20khzdesign/procorat/RAT/FOTOS RAT ORIGINAL/IMG_0858.jpg

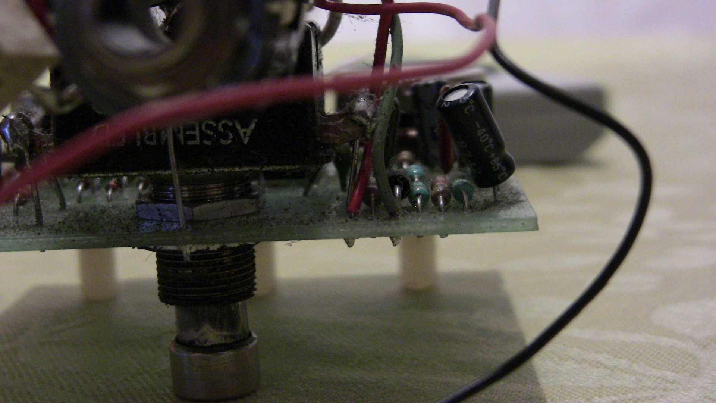
RAT/FOTOS RAT ORIGINAL/IMG_0858.jpg
