20khzdesign/procorat/RAT/FOTOS RAT ORIGINAL/IMG_0853.jpg

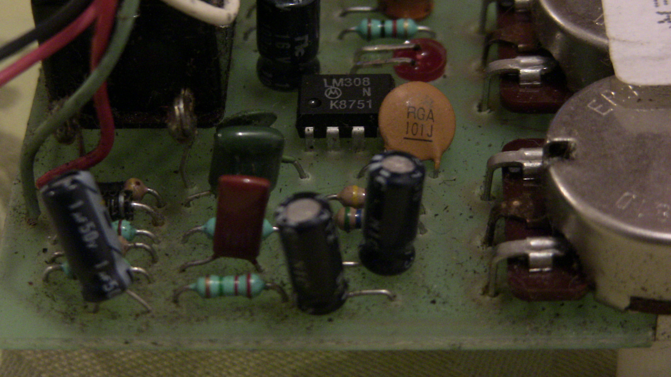
RAT/FOTOS RAT ORIGINAL/IMG_0853.jpg
