20khzdesign/procorat/RAT/LISTA COMPONENTES.txt

RESISTENCIAS

47
560
1K
1K5
2K2
10K
100K
1M
2M2
22M

CONDENSADORES

30pF
100pF
1K
3K3
10K
22K

ELECTROLITICOS

1uF
2u2
4u7
10uF
100uF

DIODOS

1N4001
1N4148

TRANSISTORES

2N5458

IC

LM308
