20khzdesign/procorat/Ficheros imprimir/PISTAS.jpg

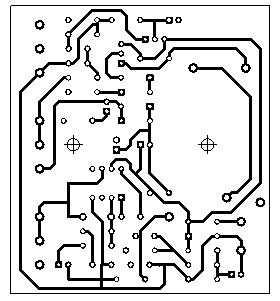
Ficheros imprimir/PISTAS.jpg
