20khzdesign/procorat/Ficheros imprimir/Referencias.jpg

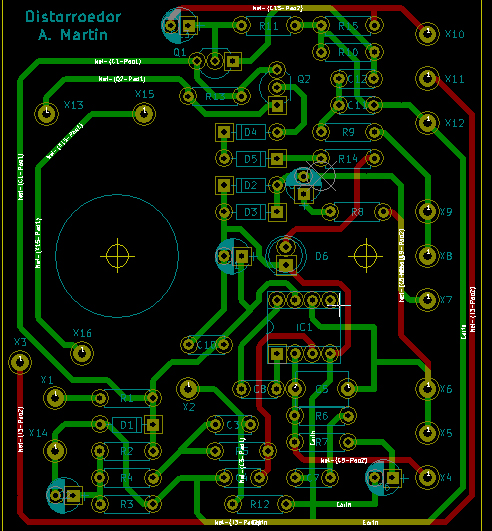
Ficheros imprimir/Referencias.jpg
