20khzdesign/procorat/Ficheros imprimir/Valores.jpg

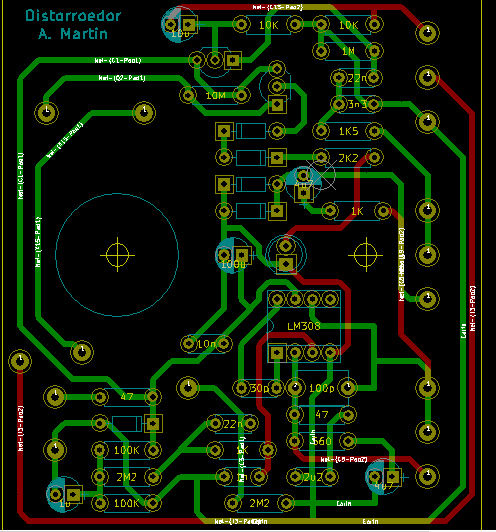
Ficheros imprimir/Valores.jpg
