20khzdesign/procorat/RAT/FOTOS RAT ORIGINAL/IMG_0848.jpg

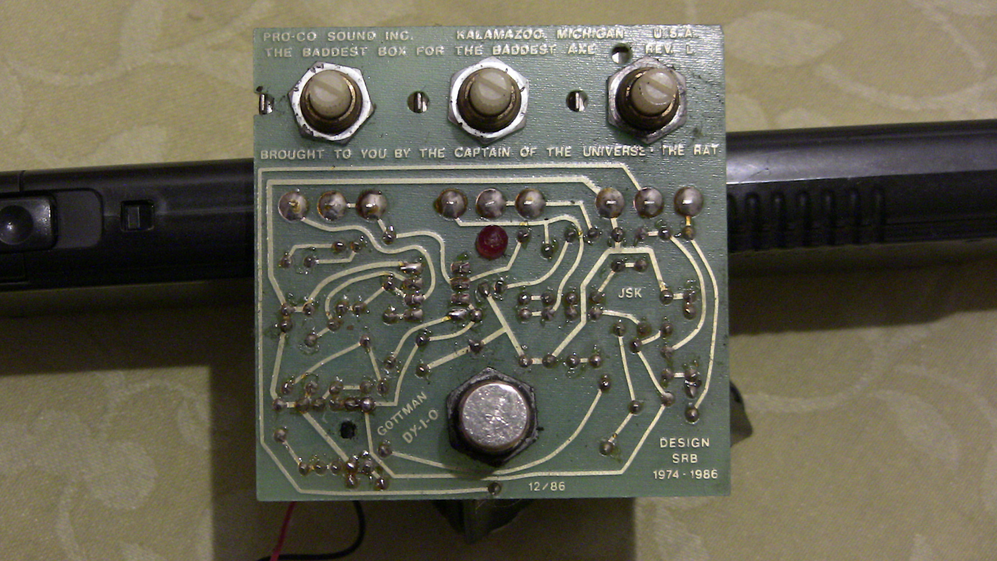
RAT/FOTOS RAT ORIGINAL/IMG_0848.jpg
