20khzdesign/procorat/RAT/FOTOS RAT ORIGINAL/IMG_0849.jpg

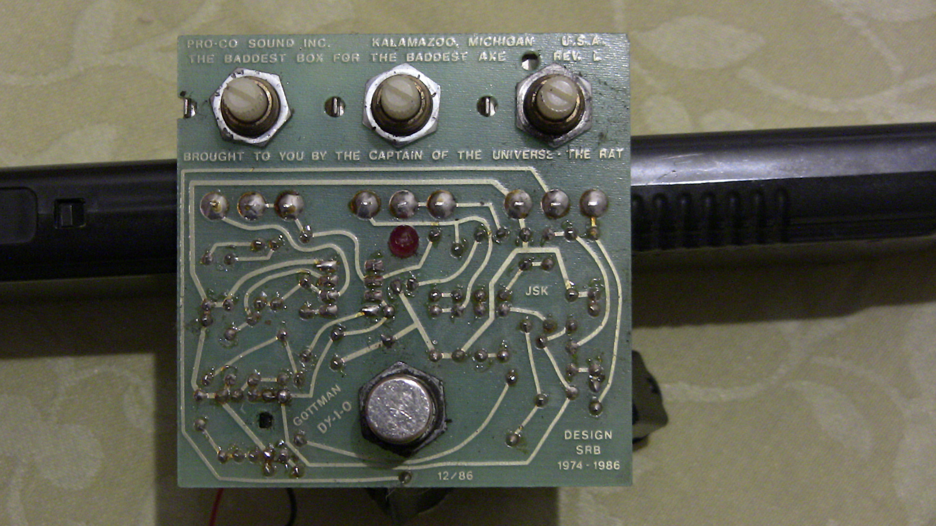
RAT/FOTOS RAT ORIGINAL/IMG_0849.jpg
