20khzdesign/procorat/RAT/FOTOS RAT ORIGINAL/IMG_0850.jpg

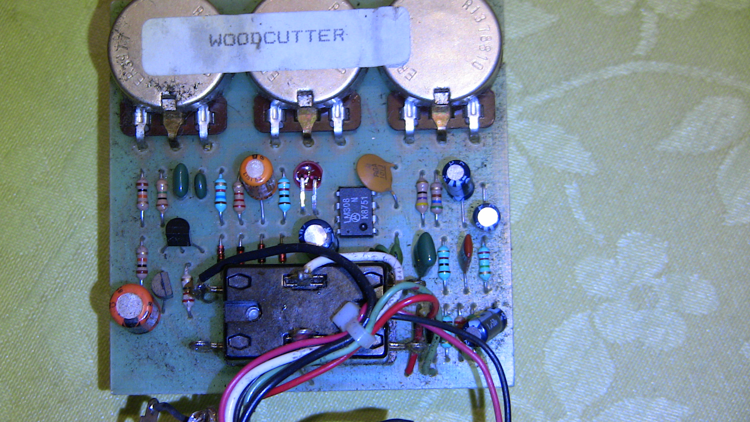
RAT/FOTOS RAT ORIGINAL/IMG_0850.jpg
