20khzdesign/procorat/RAT/FOTOS RAT ORIGINAL/IMG_0851.jpg

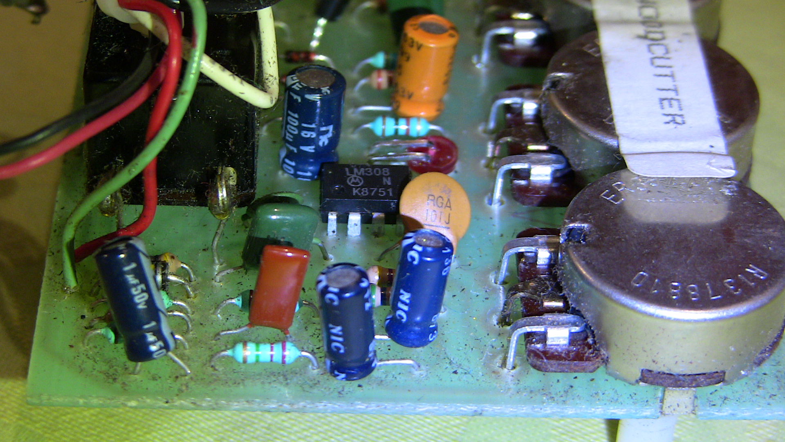
RAT/FOTOS RAT ORIGINAL/IMG_0851.jpg
