20khzdesign/procorat/RAT/FOTOS RAT ORIGINAL/IMG_0854.jpg

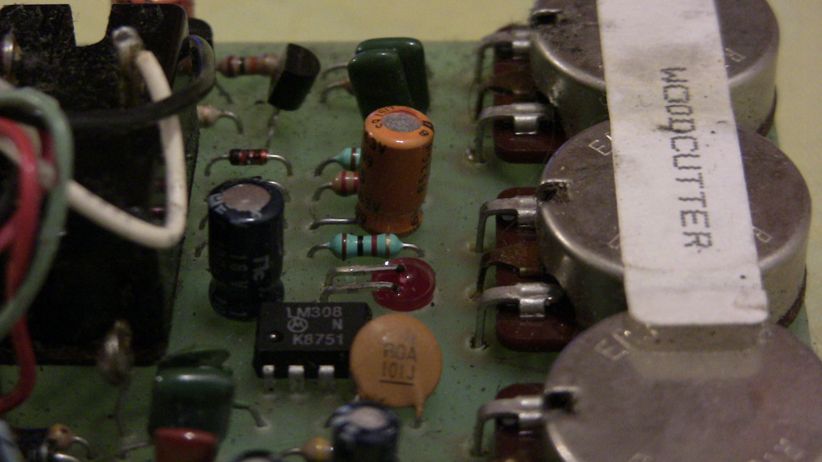
RAT/FOTOS RAT ORIGINAL/IMG_0854.jpg
