20khzdesign/procorat/RAT/FOTOS RAT ORIGINAL/IMG_0856.jpg

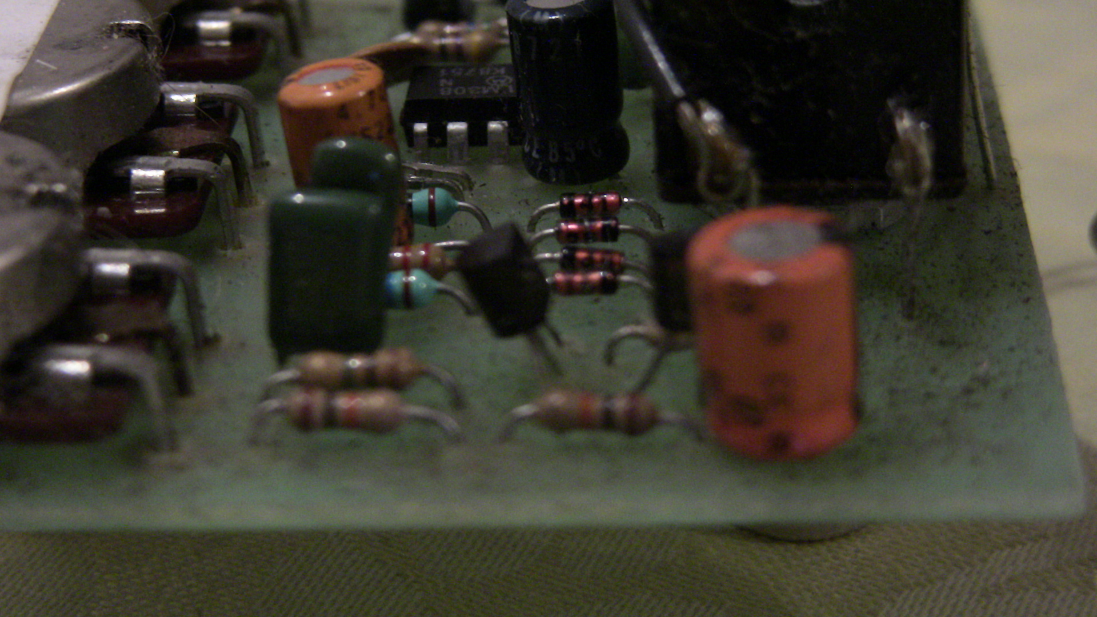
RAT/FOTOS RAT ORIGINAL/IMG_0856.jpg
