20khzdesign/procorat/RAT/FOTOS RAT ORIGINAL/IMG_0859.jpg

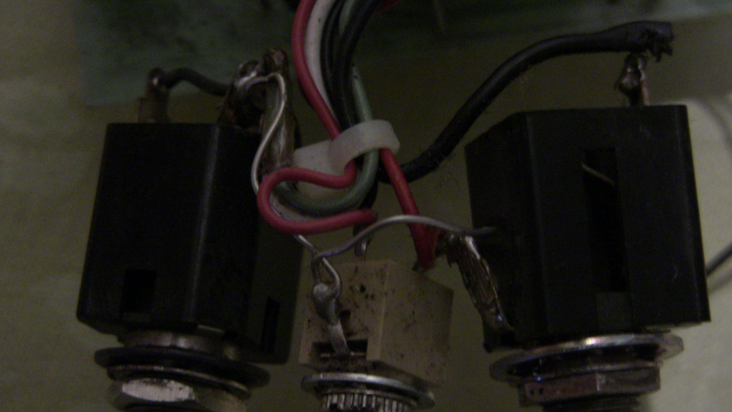
RAT/FOTOS RAT ORIGINAL/IMG_0859.jpg
