20khzdesign/procorat/RAT/RAT DE PISOTONES/ProCo RAT_archivos/image001.jpg

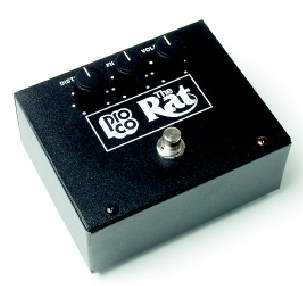
RAT/RAT DE PISOTONES/ProCo RAT_archivos/image001.jpg
