20khzdesign/procorat/RAT/RAT DE PISOTONES/ProCo RAT_archivos/image003.jpg

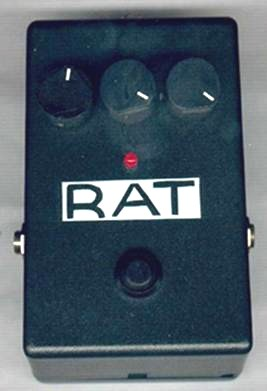
RAT/RAT DE PISOTONES/ProCo RAT_archivos/image003.jpg
