20khzdesign/procorat/RAT/RAT DE PISOTONES/ProCo RAT_archivos/image005.jpg

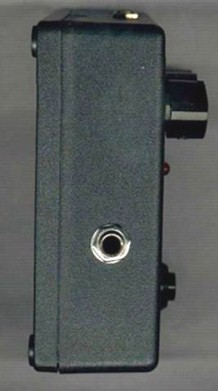
RAT/RAT DE PISOTONES/ProCo RAT_archivos/image005.jpg
