20khzdesign/procorat/RAT/RAT DE PISOTONES/ProCo RAT_archivos/RATlayout.jpg

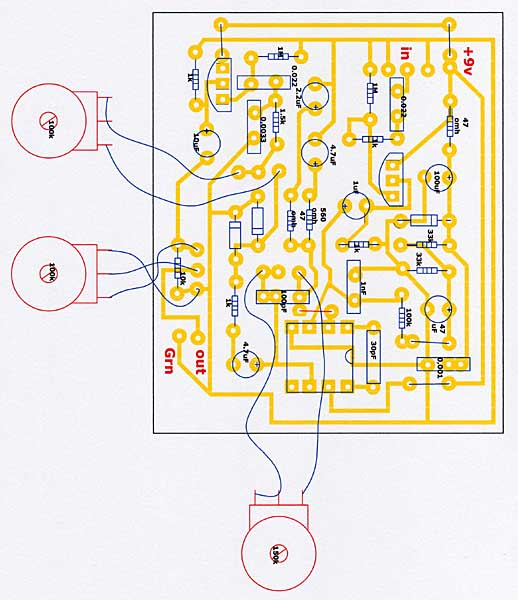
RAT/RAT DE PISOTONES/ProCo RAT_archivos/RATlayout.jpg
