20khzdesign/procorat/RAT/TUBE SOUND FUZZ PISOTONES/Tube Sound Fuzz_archivos/TSFEsquemaYComp.jpg

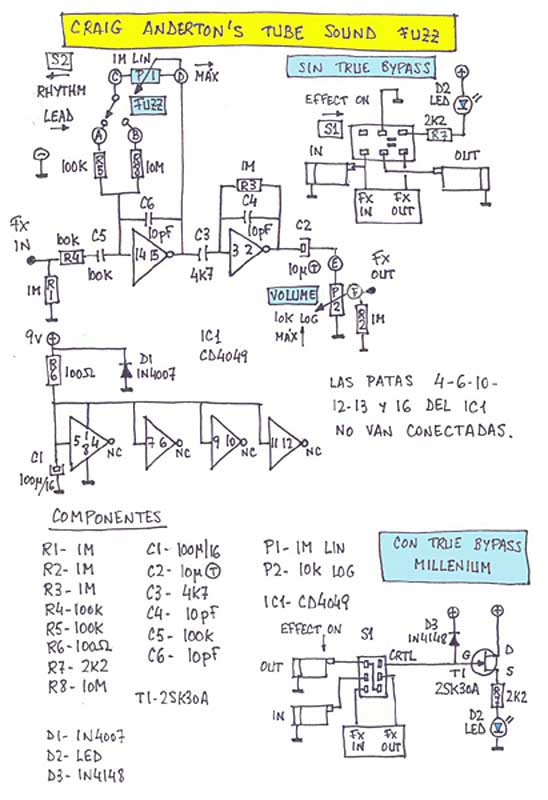
RAT/TUBE SOUND FUZZ PISOTONES/Tube Sound Fuzz_archivos/TSFEsquemaYComp.jpg
