20khzdesign/procorat/RAT/TUBE SOUND FUZZ PISOTONES/Tube Sound Fuzz_archivos/TSFExterior.jpg

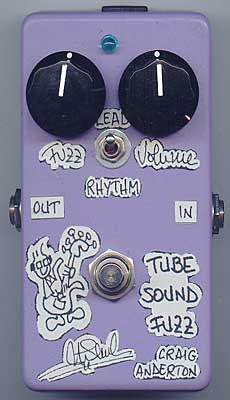
RAT/TUBE SOUND FUZZ PISOTONES/Tube Sound Fuzz_archivos/TSFExterior.jpg
