20khzdesign/procorat/RAT/TUBE SOUND FUZZ PISOTONES/Tube Sound Fuzz_archivos/TSFInterior.jpg

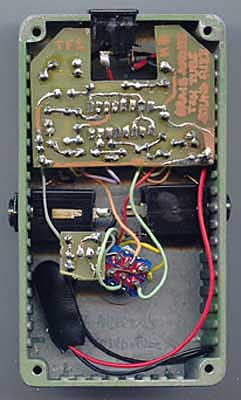
RAT/TUBE SOUND FUZZ PISOTONES/Tube Sound Fuzz_archivos/TSFInterior.jpg
