20khzdesign/procorat/RAT/TUBE SOUND FUZZ PISOTONES/Tube Sound Fuzz_archivos/TSFPlaca.jpg

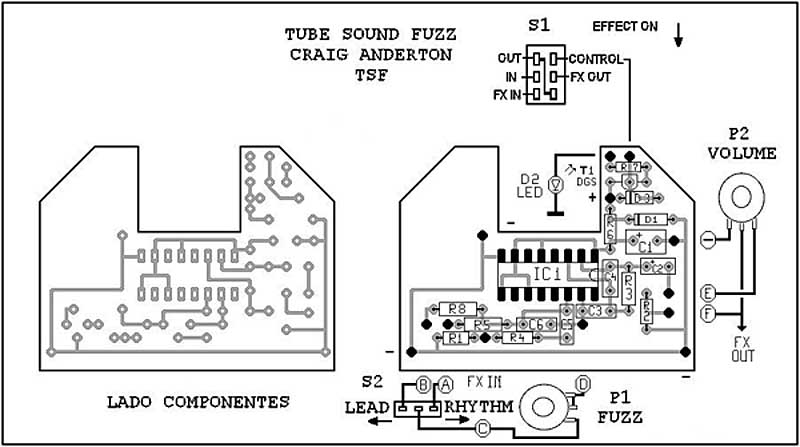
RAT/TUBE SOUND FUZZ PISOTONES/Tube Sound Fuzz_archivos/TSFPlaca.jpg
