20khzdesign/procorat/Esquema.pdf

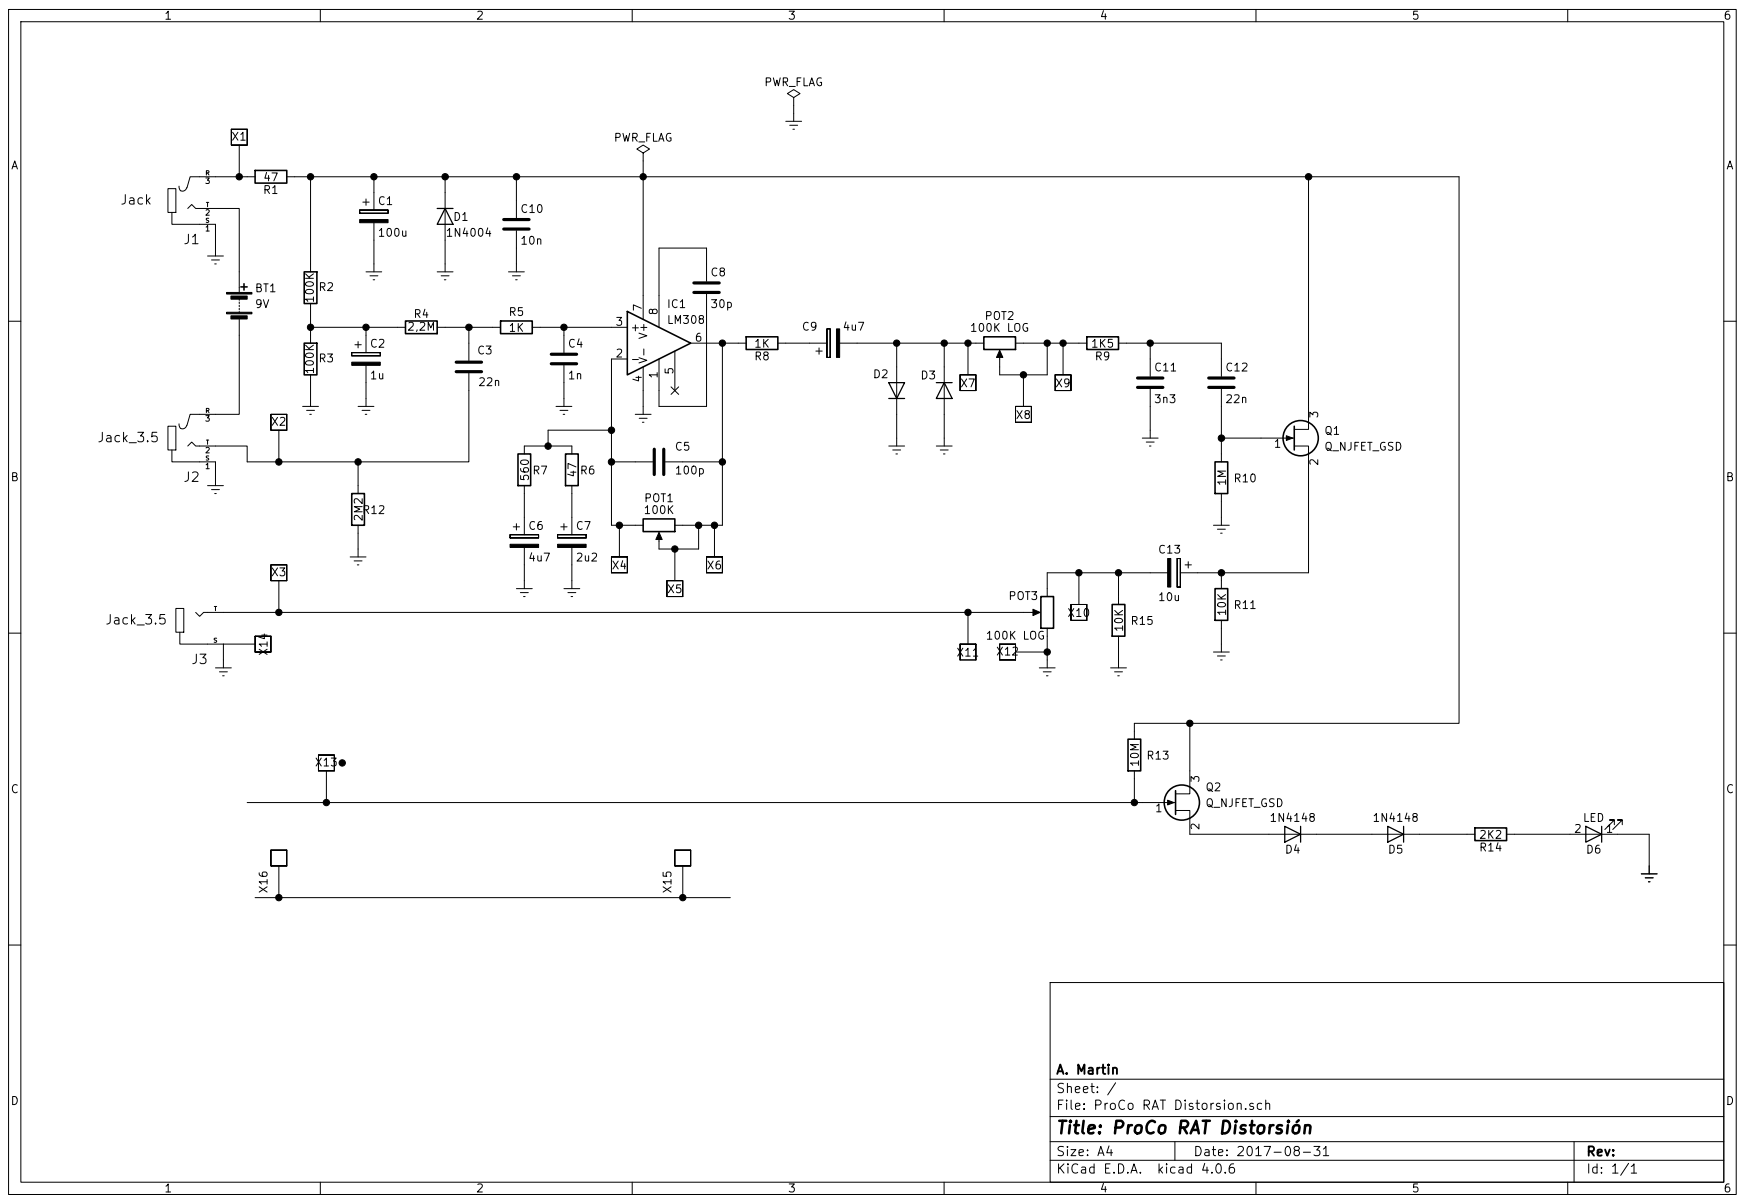
[picture p21: page 1]
