20khzdesign/procorat/Placa referencias.pdf

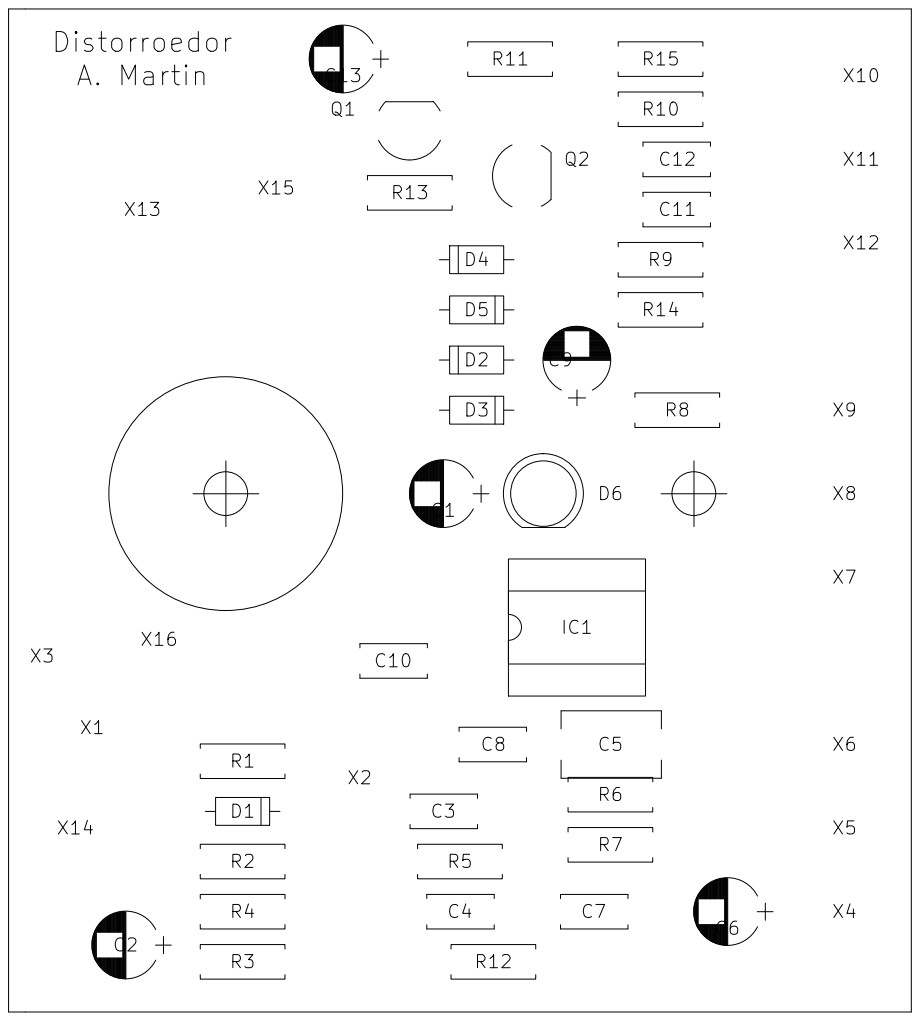
[picture p22: page 1]
