20khzdesign/procorat/Placa valores.pdf

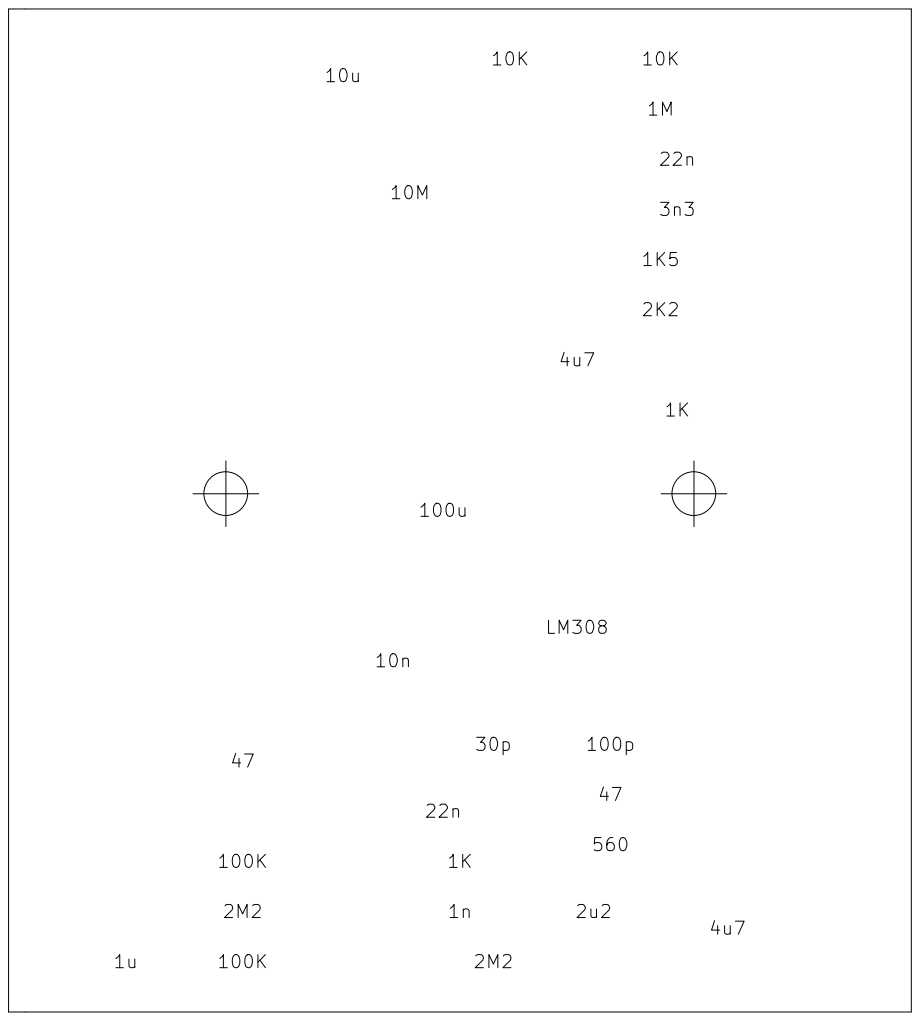
[picture p23: page 1]
