20khzdesign/procorat/Ficheros imprimir/Esquema.pdf

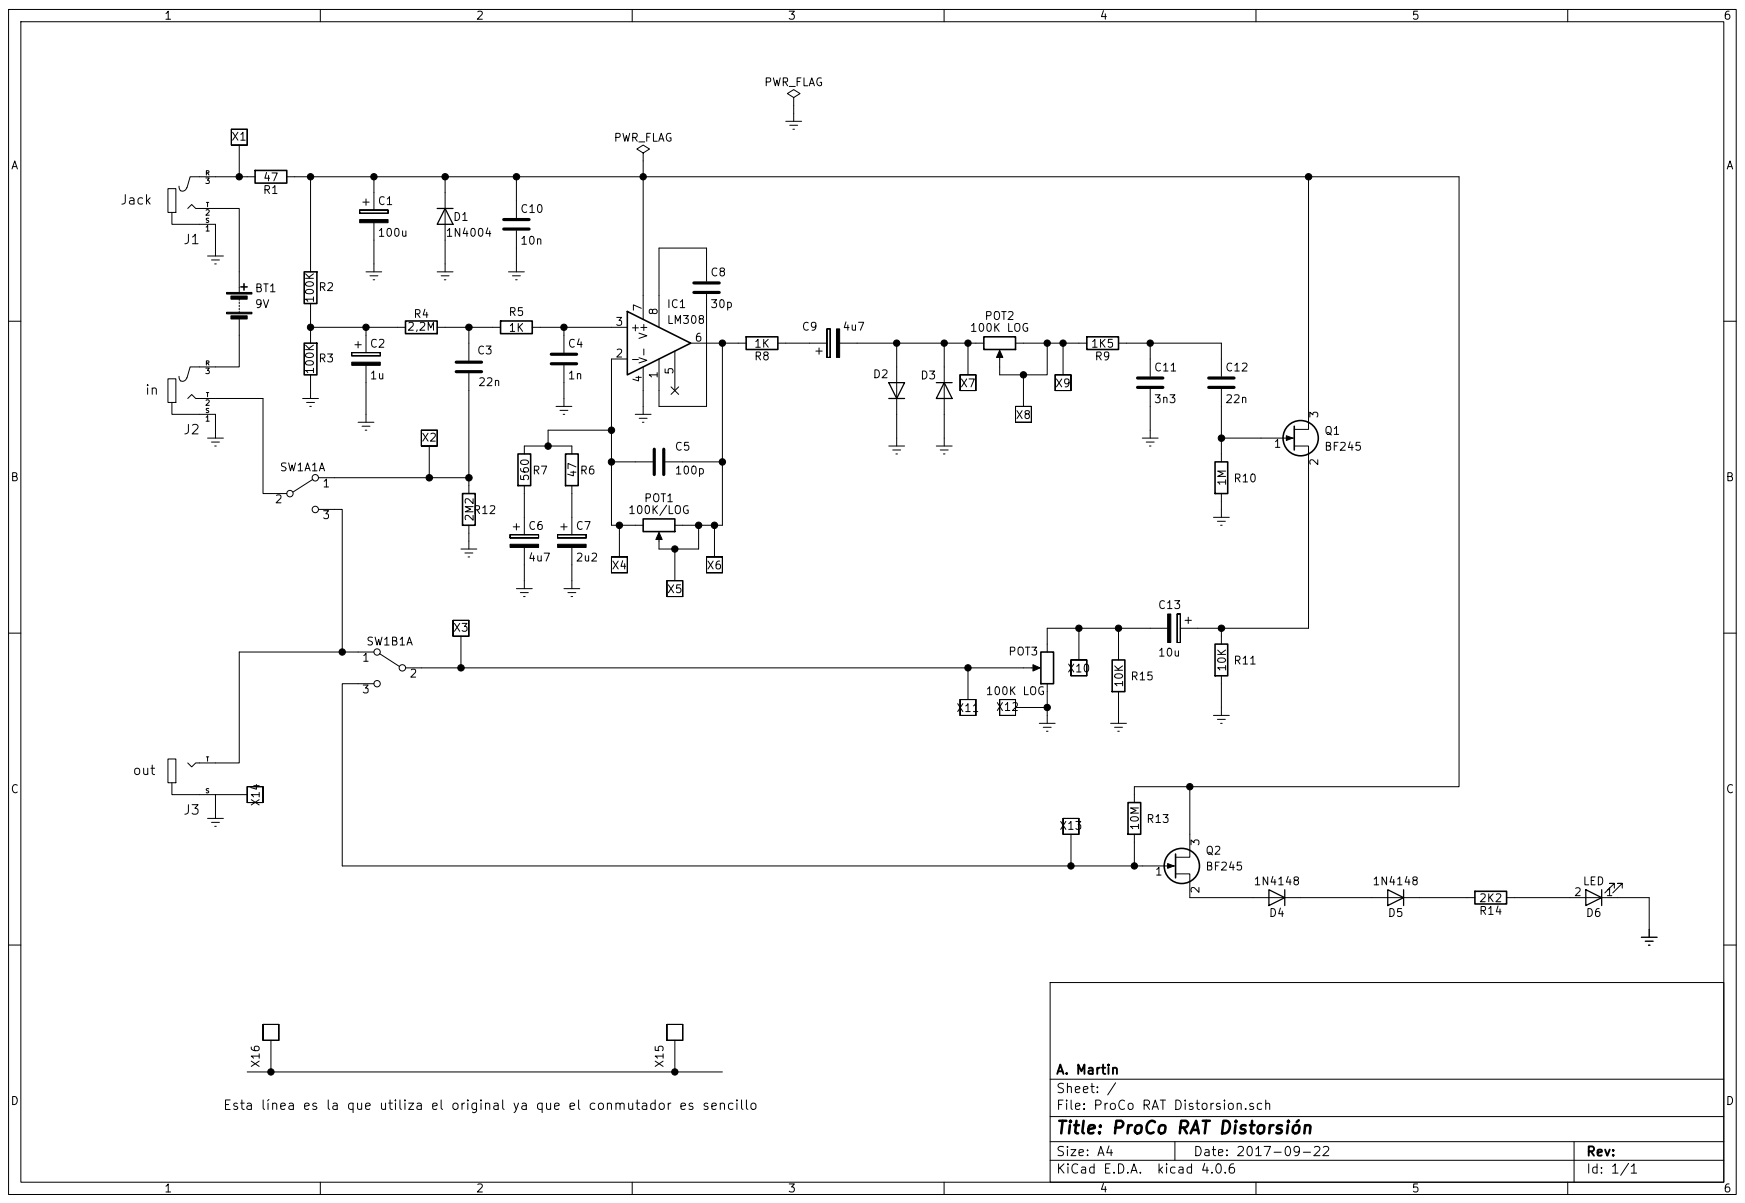
[picture p24: page 1]
