20khzdesign/procorat/RAT/Ficheros antiguos/circuito impreso componentes.pdf

# PILA

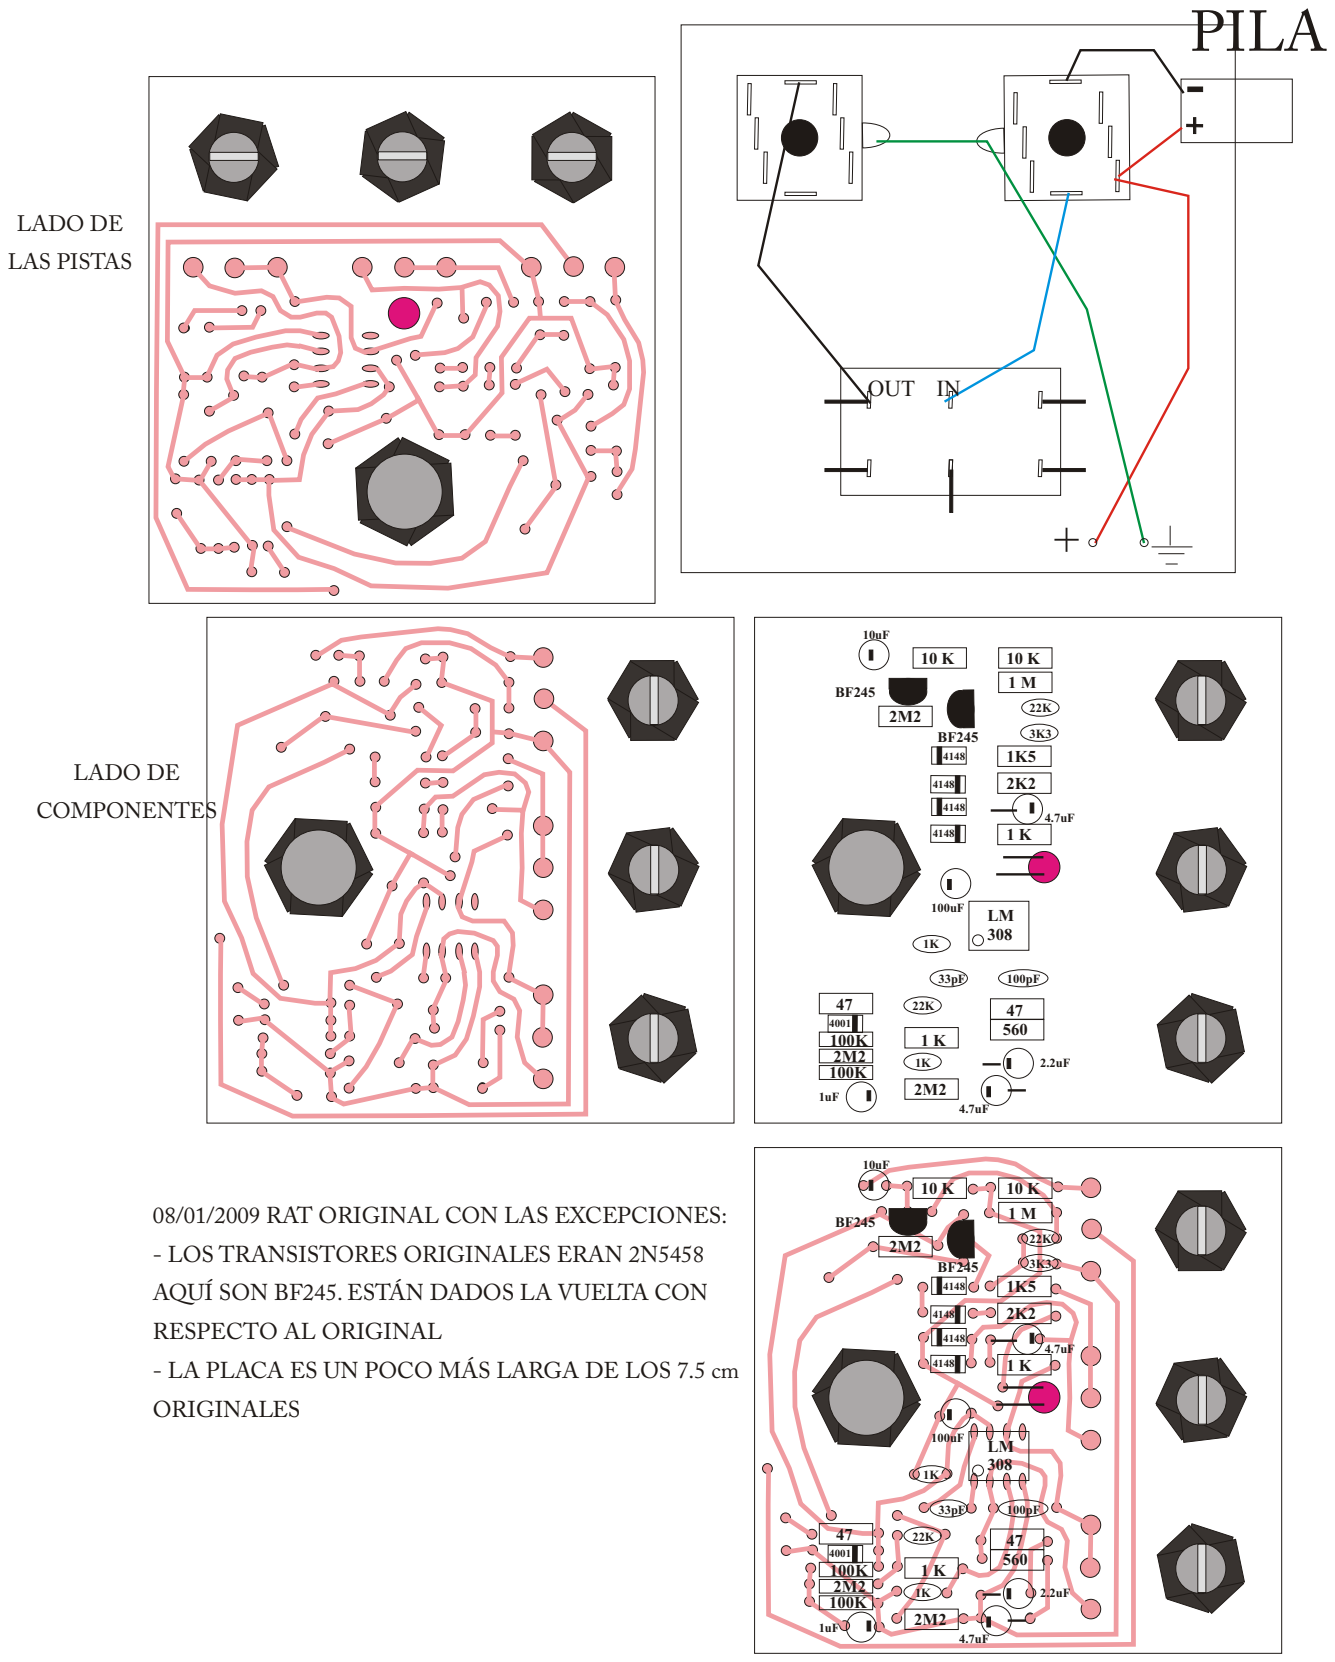
[picture p25: page 1]
LADO DE; LAS PISTAS; COMPONENTES; ORIGINALES; OUT IN

08/01/2009 RAT ORIGINAL CON LAS EXCEPCIONES:
- LOS TRANSISTORES ORIGINALES ERAN 2N5458
AQUÍ SON BF245. ESTÁN DADOS LA VUELTA CON

RESPECTO AL ORIGINAL
- LA PLACA ES UN POCO MÁS LARGA DE LOS 7.5 cm
