20khzdesign/procorat/ProCo RAT Distorsion.kicad_pcb

## KiCad design ProCo RAT Distorsion.kicad_pcb (2017-09-26)

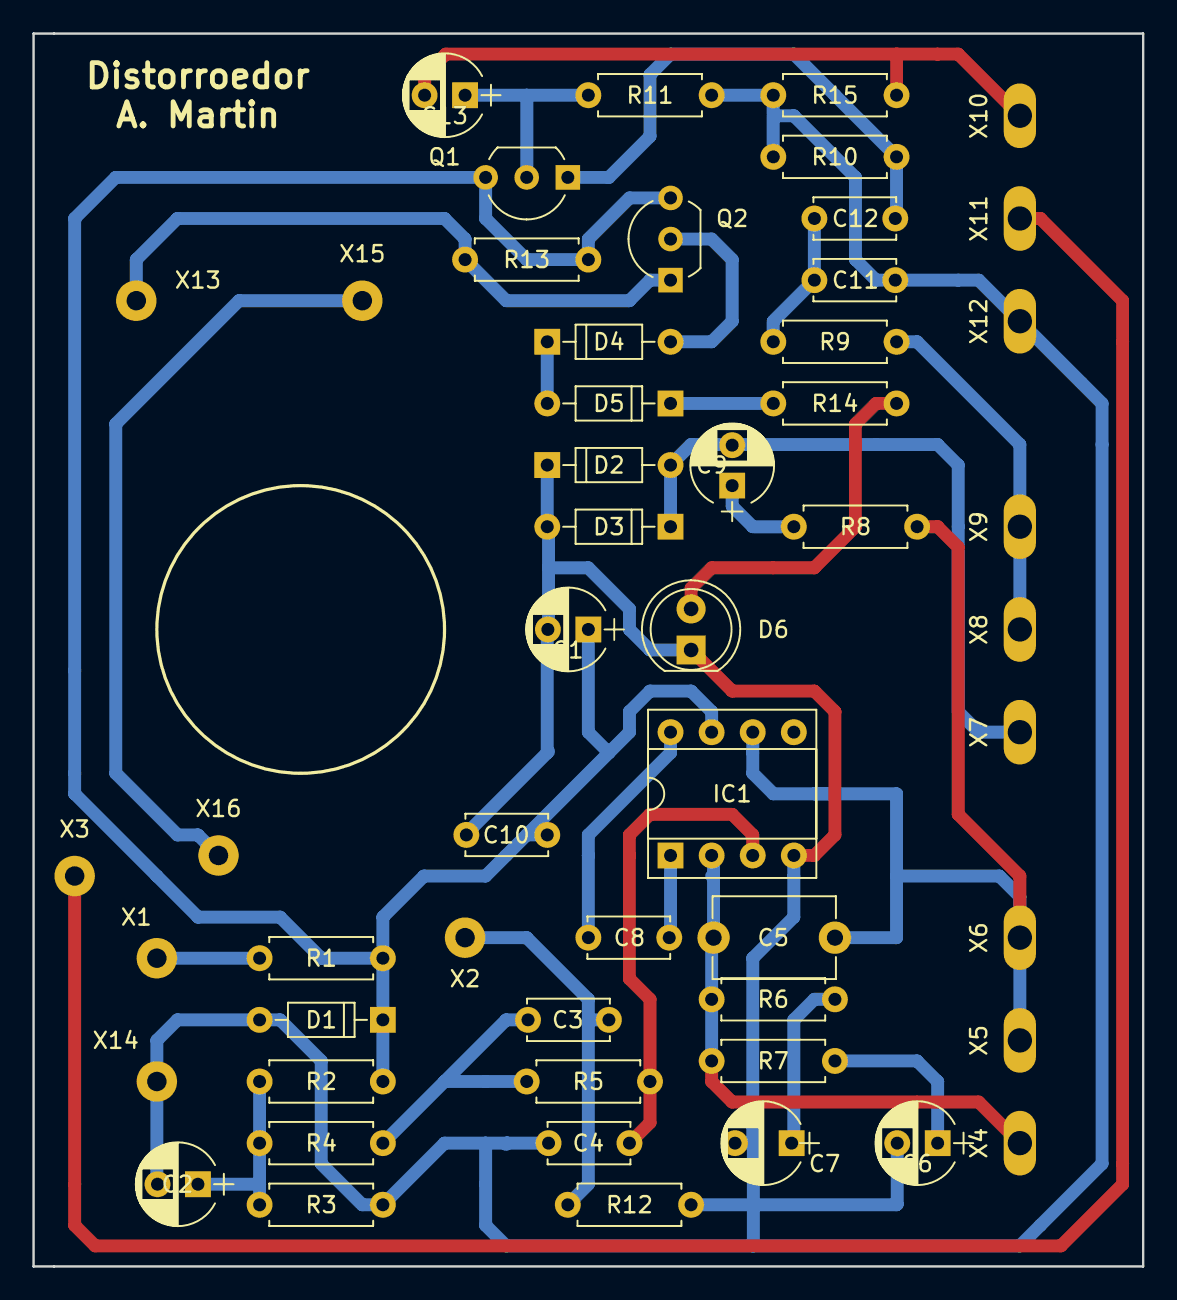
[picture p26: board ProCo RAT Distorsion.kicad_pcb from above]

Board: 2 copper layers, 68.6 x 76.2 mm, 53 parts (0 on the bottom side), 27 nets.

Parts:
C1: 100u; CP1
C2: 1u; CP1
C3, C12: 22n; C1
C4: 1n; C1
C5: 100p; C_Disc_D7.5mm_W5.0mm_P7.50mm
C6, C9: 4u7; CP1
C7: 2u2; CP2
C8: 30p; C1
C10: 10n; C1
C11: 3n3; C1
C13: 10u; CP1
D1: 1N4004; D_DO-35_SOD27_P7.62mm_Horizontal
D2, D3: D; D_DO-35_SOD27_P7.62mm_Horizontal
D4, D5: 1N4148; D_DO-35_SOD27_P7.62mm_Horizontal
D6: LED; LED_D5.0mm_FlatTop
IC1: LM308; DIP_8
Q1, Q2: BF245; TO-92_Inline_Wide
R1, R6: 47; R
R2, R3: 100K; R
R4: 2,2M; R
R5, R8: 1K; R
R7: 560; R
R9: 1K5; R
R10: 1M; R
R11, R15: 10K; R
R12: 2M2; R
R13: 10M; R
R14: 2K2; R
X1, X2, X3, X13, X14, X15, X16: JD_CONN_01X01; Pad_2,5
X4, X5, X6, X7, X8, X9, X10, X11, X12: JD_CONN_01X01; PAD_OVAL

Connections:
Earth: C1.2, C2.2, C4.2, C6.2, C7.2, C10.2, C11.2, D1.2, D2.1, D3.2, D6.1, IC1.4, R3.1, R10.2, R11.2, R12.2, R15.2, X12.1, X14.1
unnamed: C1.1, C10.1, D1.1, IC1.7, Q1.3, Q2.3, R1.1, R2.2, R13.1
unnamed: C2.1, R2.1, R3.2, R4.1
unnamed: C3.1, R12.1, X2.1
unnamed: C3.2, R4.2, R5.2
unnamed: C4.1, IC1.3, R5.1
unnamed: C5.1, IC1.6, R8.2, X5.1, X6.1
unnamed: C5.2, IC1.2, R6.1, R7.1, X4.1
unnamed: C6.1, R7.2
unnamed: C7.1, R6.2
unnamed: C8.1, IC1.8
unnamed: C8.2, IC1.1
unnamed: C9.1, R8.1
unnamed: C9.2, D2.2, D3.1, X7.1
unnamed: C11.1, C12.1, R9.1
unnamed: C12.2, Q1.1, R10.1
unnamed: C13.1, Q1.2, R11.1
unnamed: C13.2, R15.1, X10.1
unnamed: D4.1, D5.2
unnamed: D4.2, Q2.2
unnamed: D5.1, R14.2
unnamed: D6.2, R14.1
unnamed: R1.2, X1.1
unnamed: R9.2, X8.1, X9.1
unnamed: X3.1, X11.1
unnamed: Q2.1, R13.2, X13.1
unnamed: X15.1, X16.1
