20khzdesign/procorat/(commit log)

2017-09-08 commit inicial
    [ProCo RAT Distorsion-B.Cu.gbr, ProCo RAT Distorsion-B.Mask.gbr, ProCo RAT Distorsion-B.SilkS.gbr, ProCo RAT Distorsion-Edge.Cuts.gbr, ProCo RAT Distorsion-F.Cu.gbr, ProCo RAT Distorsion-F.Mask.gbr, ProCo RAT Distorsion-F.SilkS.gbr, ProCo RAT Distorsion.drl]
2017-09-26 correcciones y documentacion
    [ProCo RAT Distorsion.kicad_pcb, ProCo RAT Distorsion.sch]
